nanbuwks/ESXAR/doc/ESXARPoster.jpg

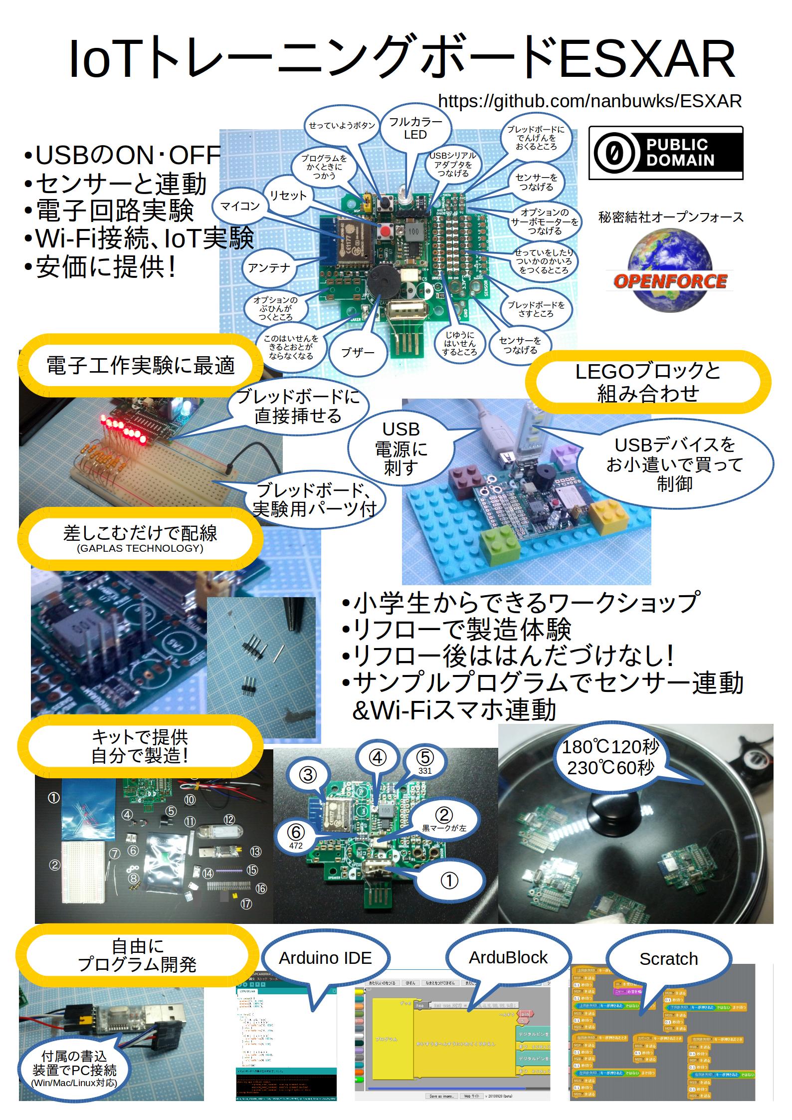
doc/ESXARPoster.jpg
