nanbuwks/ESXAR/doc/20160821IoTCost.pdf

Sheet1

ページ 1

金額は税込みです

調達価格 | | 部材価格（３倍） | ミニマムの場合
WROOM-02 | 450 | 1350
基板 | 100 | 300 | 300
FET | 100 | 300 | 30
ブレッドボード | 120 | 360 | 360
| 20 | 60 | 60
抵抗ｘ１０ | 10 | 30 | 30
温度センサ | 10 | 30 | 30
センサーねじ | 10 | 30 | 30
照度センサ | 10 | 30 | 30
スピーカ | 100 | 300 | 300
リードスイッチ | 25 | 75 | 75
| 100 | 300 | 0
集合抵抗 | 20 | 60 | 60
集合コンデンサ | 20 | 60 | 60
電源ユニット | 100 | 300 | 168
ピンヘッダ | 15 | 45 | 45
| 216 | 648
| 216 | 648
| 108 | 324
合計 | | 5250 | 1578

### 2016/8/21親子de電子工作キット部材コスト

LEDｘ４

USBメスコネクタ

USB電源
USB扇風機
USBライト
