nanbuwks/ESXAR/doc/光の流れ20160521wESP8266.pdf

## 日本アンドロイドの会秋葉原支部ロボット部

# 「ハードウェア」と「ソフトウェア」のワークショップ

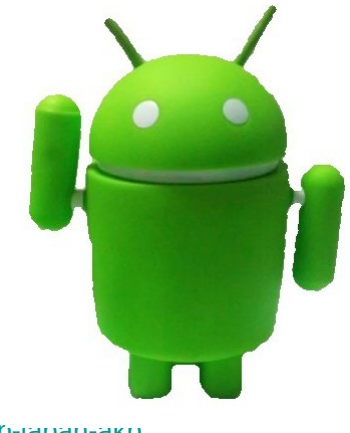
[picture p11: figure]

メーリングリスト：　　http://groups.google.com/group/robot-android-group-japan-akb Webサイト：　　　　　https://sites.google.com/site/akbrobot/

# 「光の流れ」 テキスト

### ESP8266のオリジナル電子基板を Arduino互換基板として使用して、 LEDを光るプログラムを作ります

# 「光の流れ」ワークショップ

### 目的： 「ハードウェア」と「ソフトウェア」に触れる

### 概要： 光の流れをつくる

### 対象： 小学生以上

### コース時間： 30分〜

### コース方式： 個別指導

### （１）コース説明 3分 （２）ハードウェア工作 １０分 （３）課題１（１つ点滅） ５分 （４）課題２（光の流れ） １０分 （５）まとめ、質問 3分 （６）追加の問題（流れを逆にするなど） １５分

概要

時間

# 全体のつながり

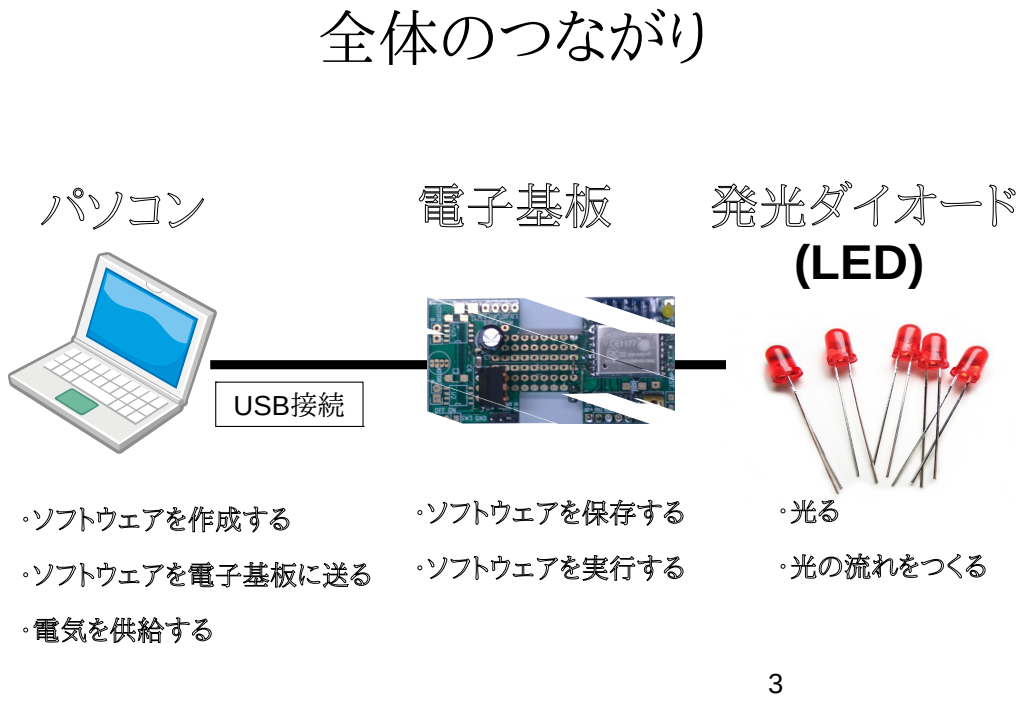
[picture p12: page 3]
・ソフトウェアを作成する; ・ソフトウェアを電子基板に送る; ・電気を供給する; ・ソフトウェアを保存する; ・ソフトウェアを実行する; ・光の流れをつくる; パソコン; 電子基板; 発光ダイオード; (LED); USB接続

# ハードウェア工作

### ①最初に先生が部品（抵抗、発光ダイオード、電線）を取り

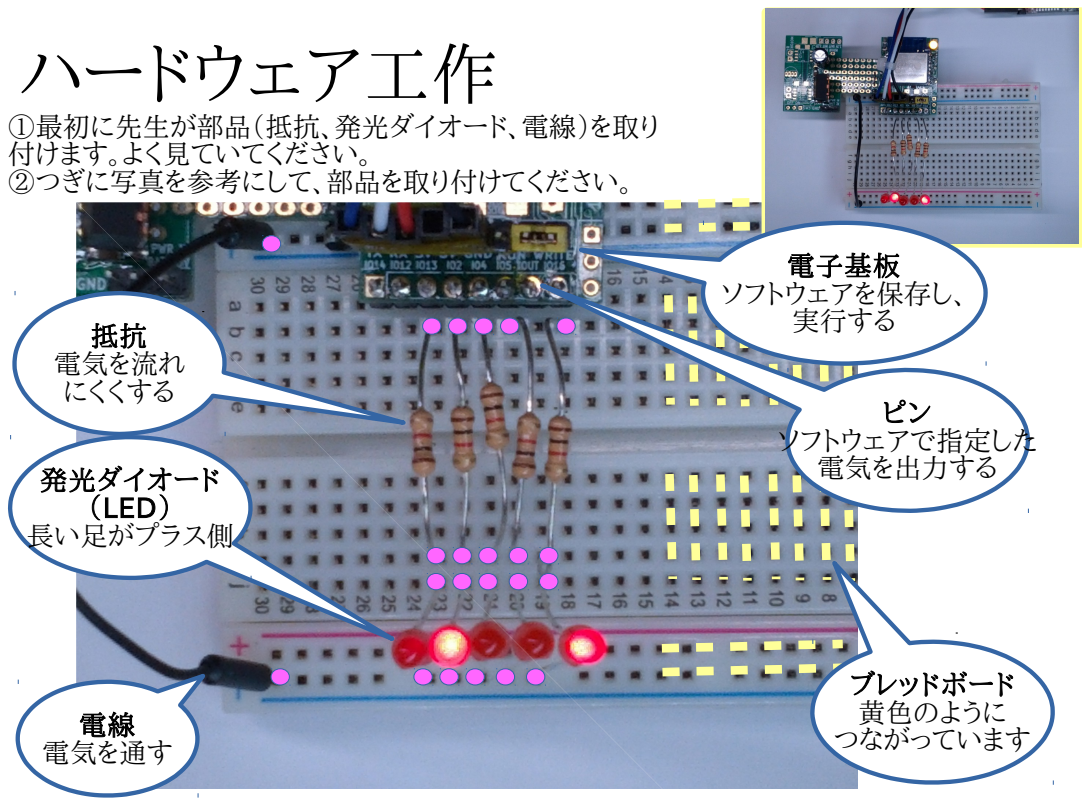
[picture p13: page 4]
付けます。よく見ていてください。 ②つぎに写真を参考にして、部品を取り付けてください。; 発光ダイオード （LED） 長い足がプラス側; 電線 電気を通す; 抵抗 電気を流れ にくくする; ブレッドボード 黄色のように つながっています; ピン ソフトウェアで指定した 電気を出力する; 電子基板 ソフトウェアを保存し、 実行する

# 「デモ１」 １つ点滅

### ソフトウェア１

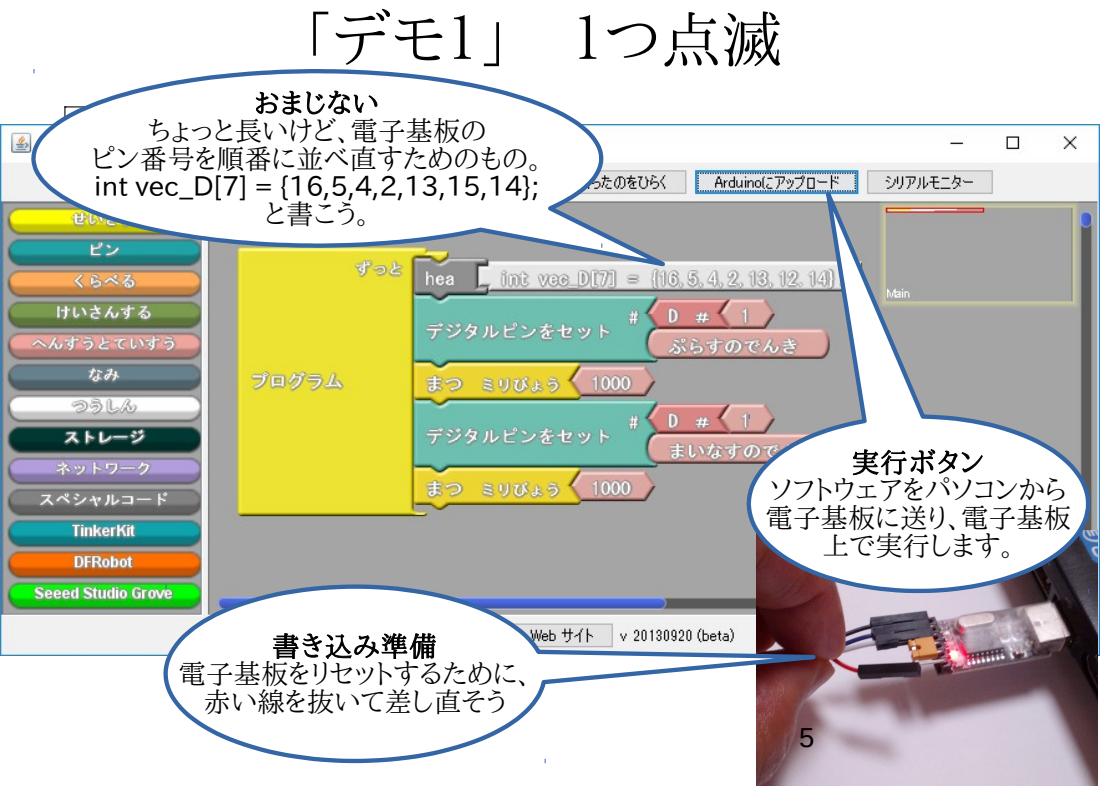
[picture p14: page 5]
実行ボタン ソフトウェアをパソコンから 電子基板に送り、電子基板 上で実行します。; おまじない ちょっと長いけど、電子基板の ピン番号を順番に並べ直すためのもの。 int vec_D[7] = {16,5,4,2,13,15,14}; と書こう。; 書き込み準備 電子基板をリセットするために、 赤い線を抜いて差し直そう

# 「デモ２」 光の流れ （発光ダイオード５本)

### ソフトウェア２

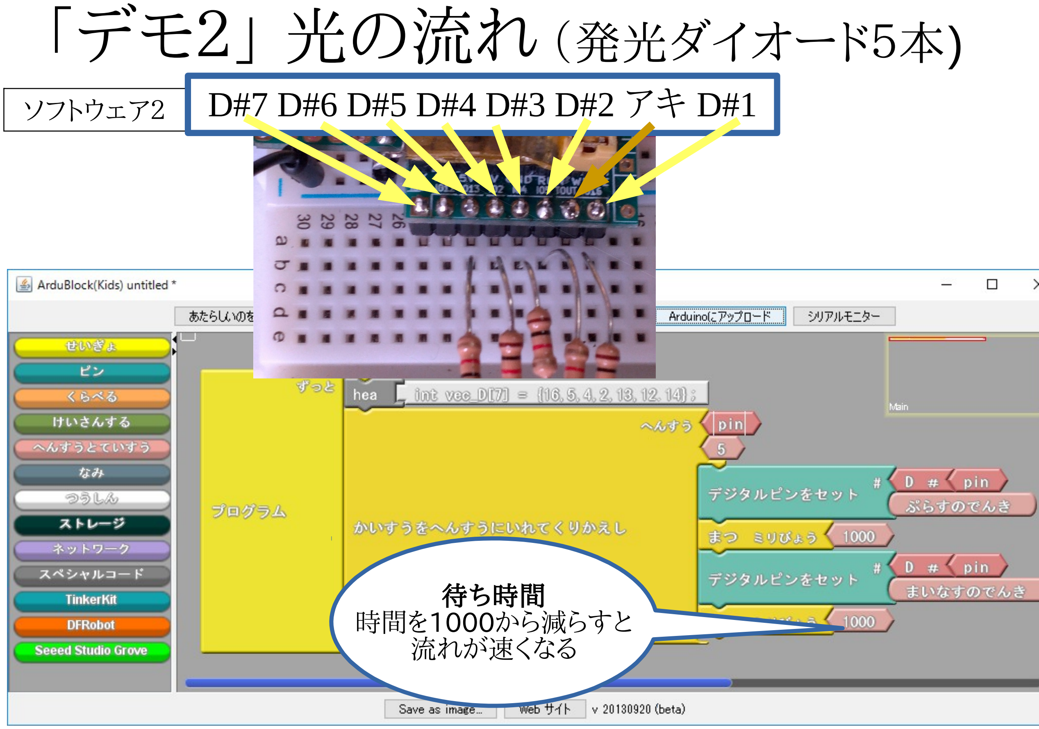
[picture p15: page 6]

### 待ち時間 時間を1000から減らすと 流れが速くなる

# D#7 D#6 D#5 D#4 D#3 D#2 アキ D#1

# 問題に挑戦しよう。

# （１）光の流れを逆方向にする （２）光の流れを折り返す （３）発光ダイオードを１つ増やす （４）その他

# 問題をとくアイデアは？

# もっと遊びたい

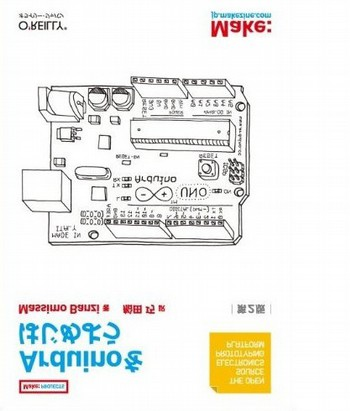
[picture p16: figure]

１．本

Arduino をはじめよう 第3版 (Make:PROJECTS) 　　￥ 2,160 入手先：アマゾン http://www.amazon.co.jp/ など

２．ハードウェア （つぎのいづれか）

（１）本テキストで使用した電子基板、部品　　「AKBONE」　価格は問い合わせください 入手先：ロボット部　http://groups.google.com/group/robot-android-group-japan-akb

（２）「Arduinoで利口なガジェット」用実験キット ￥1500
入手先：アマゾン、秋葉原　若松通商など

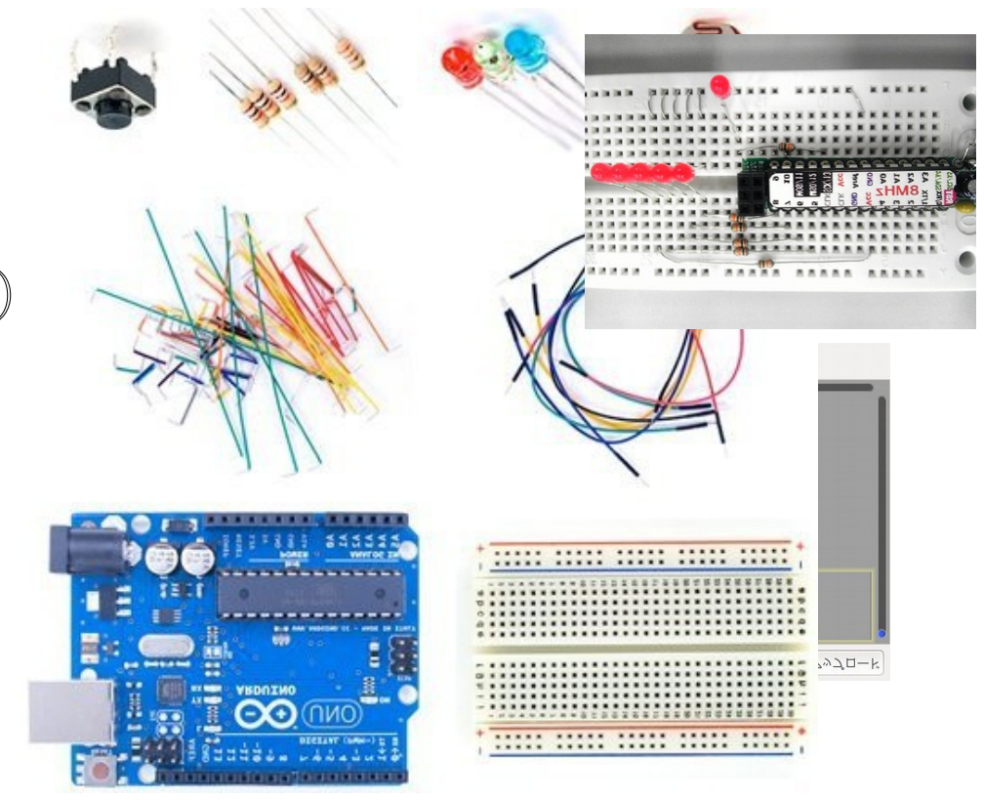
[picture p17: figure]

３．ソフトウェア開発ソフト　 （本テキストで使用したソフト）

Arduino IDE　無料　　開発環境
ArduBlock 　無料　　ビジュアルプログラミング環境

ダウンロードやインストール方法は、ロボット部の
「プロジェクトAKBONE」　などを参考にしてください。 <http://sourceforge.jp/projects/akbone>

# 参加ありがとう！
