nanbuwks/ESXAR/(threads)

Thread 3 (2016-07-29):

Bug on 4.7kOhm registor array pin assign

nanbuwks, 2016-07-29:

nanbuwks, 2016-08-02:
Done

Closed 2016-08-02.
