nanbuwks/ESXAR/doc/ESXARPoster.pdf

## リセット

## アンテナ

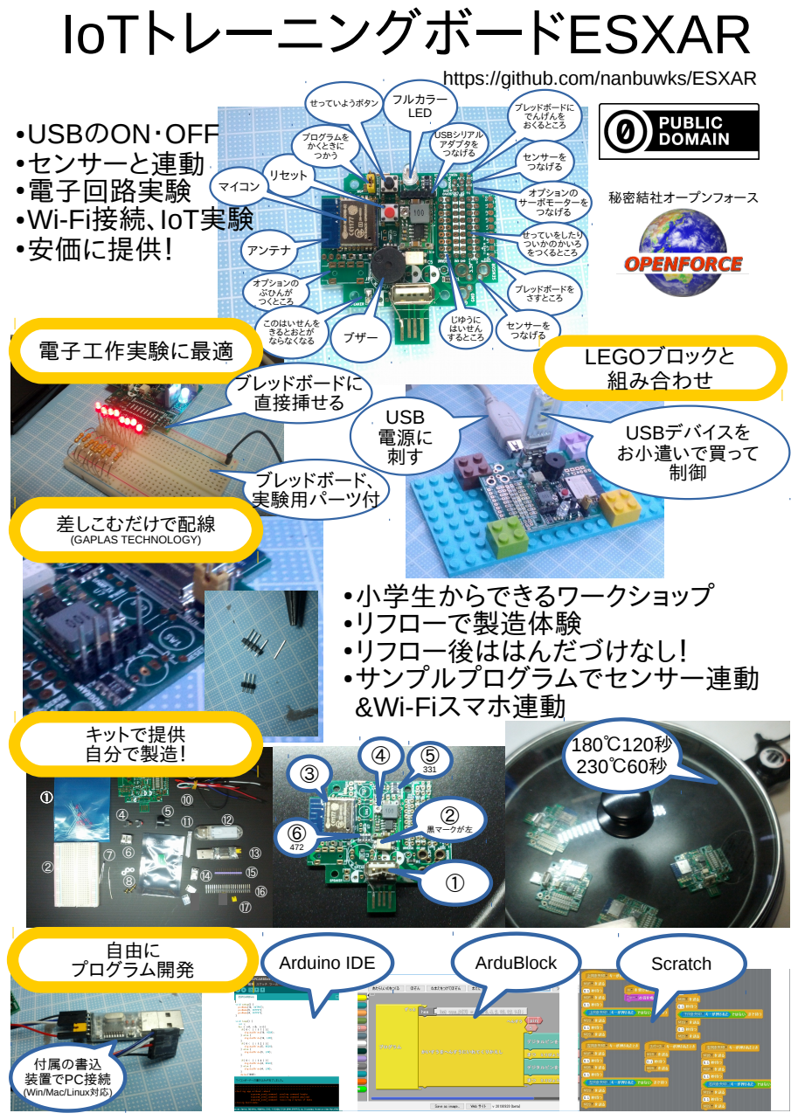
[picture p18: page 1]
黒マークが左; USB 電源に 刺す; ブザー; オプションの ぶひんが つくところ; プログラムを かくときに つかう; ブレッドボードに でんげんを おくるところ; センサーを つなげる; オプションの サーボモーターを つなげる; ブレッドボードを さすところ; このはいせんを きるとおとが ならなくなる; フルカラー LED; じゆうに はいせん するところ; USBデバイスを お小遣いで買って 制御; マイコン; USBシリアル アダプタを つなげる; せっていようボタン; せっていをしたり ついかのかいろ をつくるところ; ●小学生からできるワークショップ ●リフローで製造体験 ●リフロー後ははんだづけなし！ ●サンプルプログラムでセンサー連動 &Wi-Fiスマホ連動; IoTトレーニングボードESXAR; 秘密結社オープンフォース; Arduino IDE; ArduBlock; Scratch; 自由に プログラム開発; キットで提供 自分で製造！; 差しこむだけで配線; (GAPLAS TECHNOLOGY); 電子工作実験に最適; LEGOブロックと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

https://github.com/nanbuwks/ESXAR

●USBのON・OFF
●センサーと連動
●電子回路実験
●Wi-Fi接続、IoT実験
●安価に提供！

付属の書込
装置でPC接続
(Win/Mac/Linux対応)
