nanbuwks/ESXAR/doc/ESXARVer20160715HOWTOUSE.pdf

# ESXAR 詳しい資料

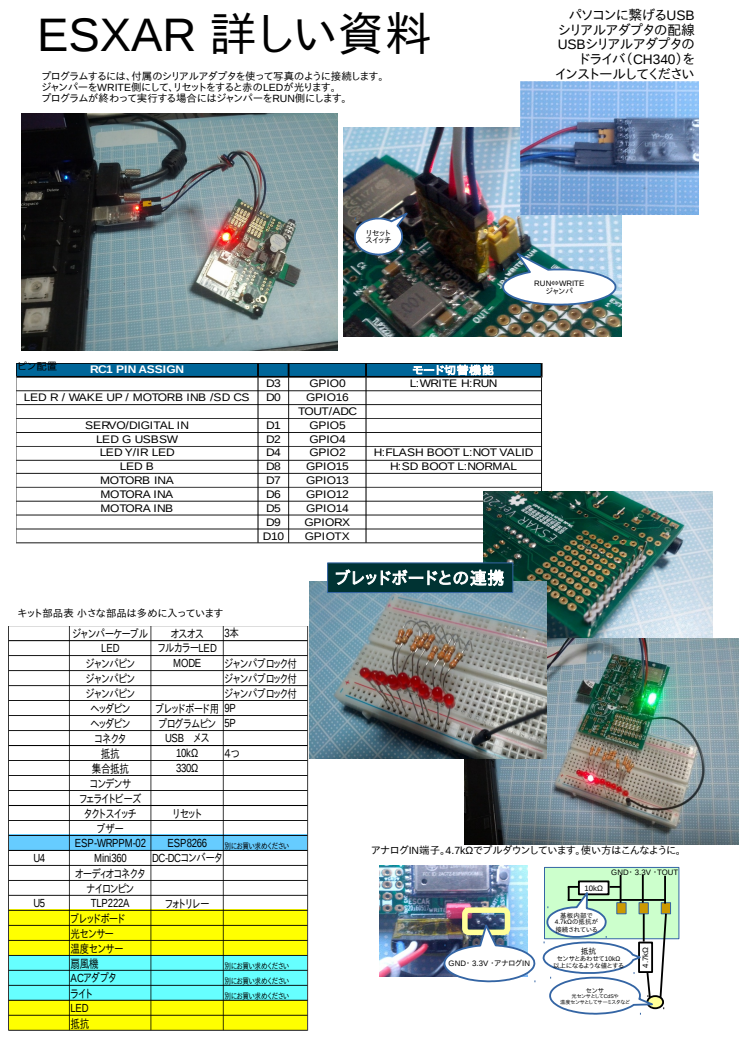
[picture p19: page 1]
