nanbuwks/ESXAR/ESXAR.kicad_pcb

## KiCad design ESXAR.kicad_pcb (2016-10-04)

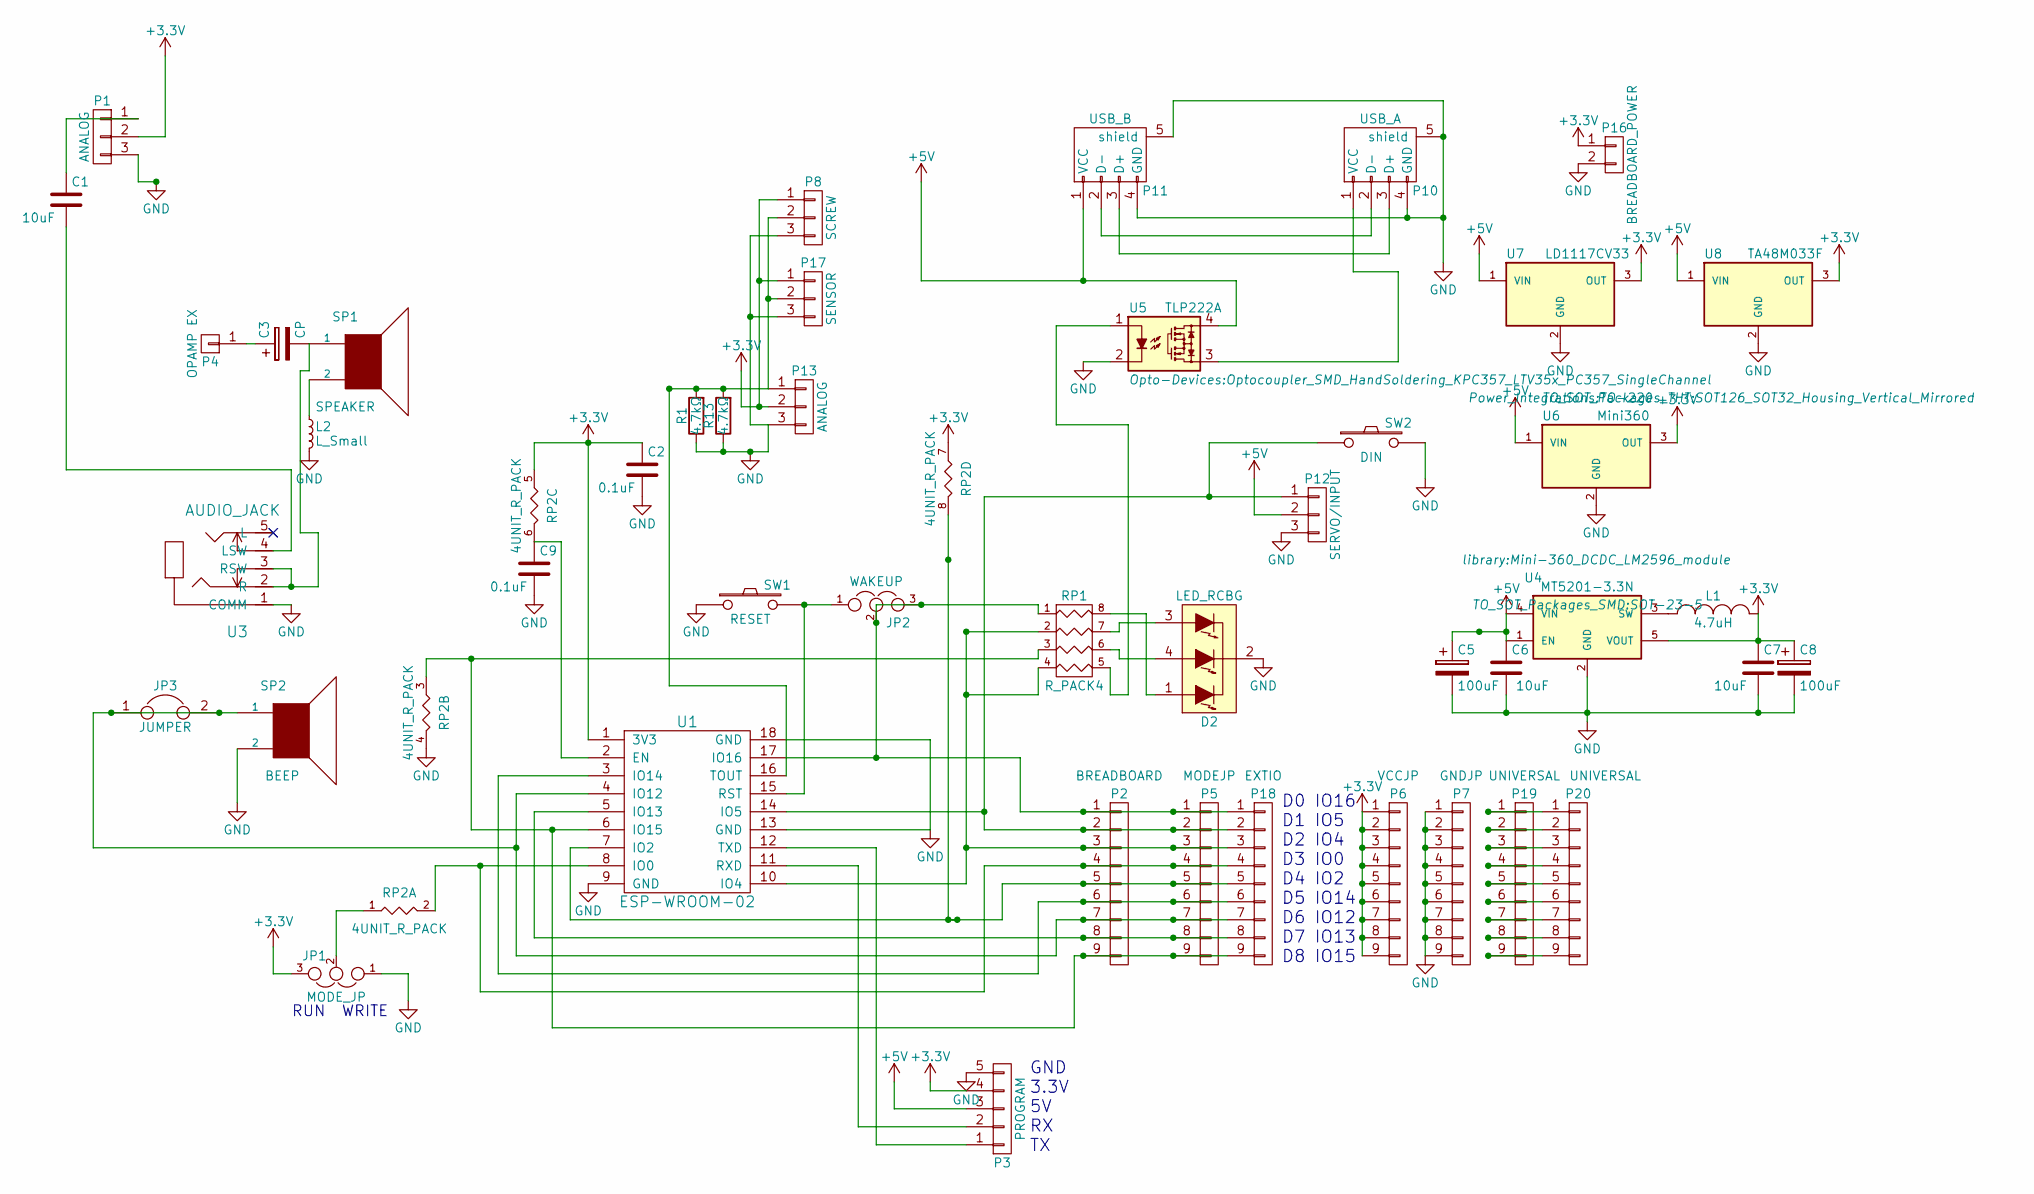
[picture p22: schematic ESXAR.sch]

Parts:
C1: 10uF; C_Disc_D3_P2.5
C2, C9: 0.1uF; C_1206_HandSoldering_Small
C3: CP; C_Radial_D6.3_L11.2_P2.5
C5, C8: 100uF; C_Radial_D6.3_L11.2_P2.5
C6, C7: 10uF; C_1206_HandSoldering_Small
D2: LED_RCBG; LED-RGB-5MM_Common_Cathode
JP1: MODE_JP; SolderWirePad_Oval_3xInline_0-65mmDrill
JP2: WAKEUP; Solder_Jumper_3
JP3: JUMPER; Pin_Header_Straight_1x02
L1: 4.7uH; C_1206_HandSoldering_Small
L2: L_Small; C_1206_HandSoldering_Small
P1, P13: ANALOG; SolderWirePad_Oval_3xInline_0-65mmDrill
P2: BREADBOARD; SolderWirePad_Oval_9xInline_0-6mmDrill
P3: PROGRAM; SolderWirePad_Oval_5xInline_0-65mmDrill
P4: OPAMP EX; SolderWirePad_single_0-8mmDrill
P5: MODEJP; SolderWirePad_Oval_9xInline_0-6mmDrill
P6: VCCJP; SolderWirePad_Oval_9xInline_0-6mmDrill
P7: GNDJP; SolderWirePad_Oval_9xInline_0-6mmDrill
P8: SCREW; bornier3
P10: USB_A; USB_A_Vertical_Short
P11: USB_B; USB_A_Male_Board
P12: SERVO/INPUT; SolderWirePad_Oval_3xInline_0-65mmDrill
P16: BREADBOARD_POWER; Padmatrix-wide-02x01
P17: SENSOR; bornier3
P18: EXTIO; SolderWirePad_Oval_9xInline_0-7mmDrill
P19, P20: UNIVERSAL; SolderWirePad_Oval_9xInline_0-7mmDrill
R1: 4.7kΩ; R_1206
R13: 4.7kΩ; R1
RP1: R_PACK4; R_Array_Convex_4x1206
RP2: 4UNIT_R_PACK; R_Array_For_R_Multi_library_4x1206
SP1: SPEAKER; Buzzer_12x9.5RM7.6
SP2: BEEP; Buzzer_12x9.5RM7.6
SW1: RESET; SW_PUSH_SMALL
SW2: DIN; SW_PUSH_SMALL
U1: ESP-WROOM-02; ESP_WROOM_02
U3: AUDIO_JACK; 3_5mm_4P_phonejack_yizhijia_PJ313
U4: MT5201-3.3N; SOT-23-5
U5: TLP222A; Optocoupler_SMD_HandSoldering_KPC357_LTV35x_PC357_SingleCha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
U6: Mini360; Mini-360_DCDC_LM2596_module
U7: LD1117CV33; TO-220
U8: TA48M033F; SOT126_SOT32_Housing_Vertical_Mirrored

Connections:
+3V3: C2.1, C7.1, C8.1, JP1.3, L1.2, P1.2, P3.4, P6.1, P6.2, P6.3, P6.4, P6.5, P6.6, P6.7, P6.8, P6.9, P8.1, P13.2, P16.1, P17.1, RP2.5 (P1), RP2.7 (P1), U1.1 (3V3), U4.5 (VOUT), U6.3 (OUT), U7.3 (OUT), U8.3 (OUT)
+5V: C5.1, C6.1, P3.3, P11.1 (VCC), P12.2, U4.1 (EN), U4.4 (VIN), U5.4, U6.1 (VIN), U7.1 (VIN), U8.1 (VIN)
GND: C2.2, C5.2, C6.2, C7.2, C8.2, C9.2, D2.2 (COMMON_CATHODE), JP1.1, L2.2, P1.3, P3.5, P7.1, P7.2, P7.3, P7.4, P7.5, P7.6, P7.7, P7.8, P7.9, P8.3, P10.4 (GND), P10.5 (shield), P11.4 (GND), P11.5 (shield), P12.3, P13.3, P16.2, P17.3, R1.1, R13.1, RP2.4 (R1), SP2.2, SW1.1, SW2.2, U1.9 (GND), U1.13 (GND), U1.18 (GND), U3.1 (COMM), U4.2 (GND), U5.2, U6.2 (GND), U7.2 (GND), U8.2 (GND)
unnamed: C1.1, P1.1
unnamed: C1.2, U3.4 (LSW)
unnamed: C3.1, P4.1
unnamed: C3.2, SP1.1, U3.2 (R), U3.3 (RSW)
unnamed: C9.1, RP2.6 (R1), U1.2 (EN)
unnamed: D2.1 (RED_ANODE), RP1.8 (R1)
unnamed: D2.3 (BLUE_ANODE), RP1.7 (R2)
unnamed: D2.4 (GREEN_ANODE), RP1.6 (R3)
unnamed: JP1.2, RP2.1
unnamed: JP2.1, SW1.2, U1.15 (RST)
unnamed: JP2.2, JP2.3, P2.1, P5.1, P18.1, RP1.1, U1.17 (IO16)
unnamed: JP3.1, JP3.2, P2.7, P5.7, P18.7, SP2.1, U1.4 (IO12)
unnamed: L1.1, U4.3 (SW)
unnamed: L2.1, SP1.2
unnamed: P3.1, U1.12 (TXD)
unnamed: P3.2, U1.11 (RXD)
unnamed: P10.1 (VCC), U5.3
unnamed: P10.2 (D-), P11.2 (D-)
unnamed: P10.3 (D+), P11.3 (D+)
unnamed: P2.2, P5.2, P12.1, P18.2, SW2.1, U1.14 (IO5)
unnamed: P8.2, P13.1, P17.2, R1.2, R13.2, U1.16 (TOUT)
unnamed: P2.3, P5.3, P18.3, RP1.2, RP1.4, U1.10 (IO4)
unnamed: P2.4, P5.4, P18.4, RP2.2 (R1), U1.8 (IO0)
unnamed: P2.5, P5.5, P18.5, RP2.8 (R1), U1.7 (IO2)
unnamed: P2.6, P5.6, P18.6, U1.3 (IO14)
unnamed: P2.8, P5.8, P18.8, U1.5 (IO13)
unnamed: P2.9, P5.9, P18.9, RP1.3, RP2.3 (P1), U1.6 (IO15)
unnamed: P19.1, P20.1
unnamed: P19.2, P20.2
unnamed: P19.3, P20.3
unnamed: P19.4, P20.4
unnamed: P19.5, P20.5
unnamed: P19.6, P20.6
unnamed: P19.7, P20.7
unnamed: P19.8, P20.8
unnamed: P19.9, P20.9
unnamed: RP1.5 (R4), U5.1

Notes on the sheet:
RUN WRITE
GND 3.3V 5V RX TX
D0 IO16 D1 IO5 D2 IO4 D3 IO0 D4 IO2 D5 IO14 D6 IO12 D7 IO13 D8 IO15

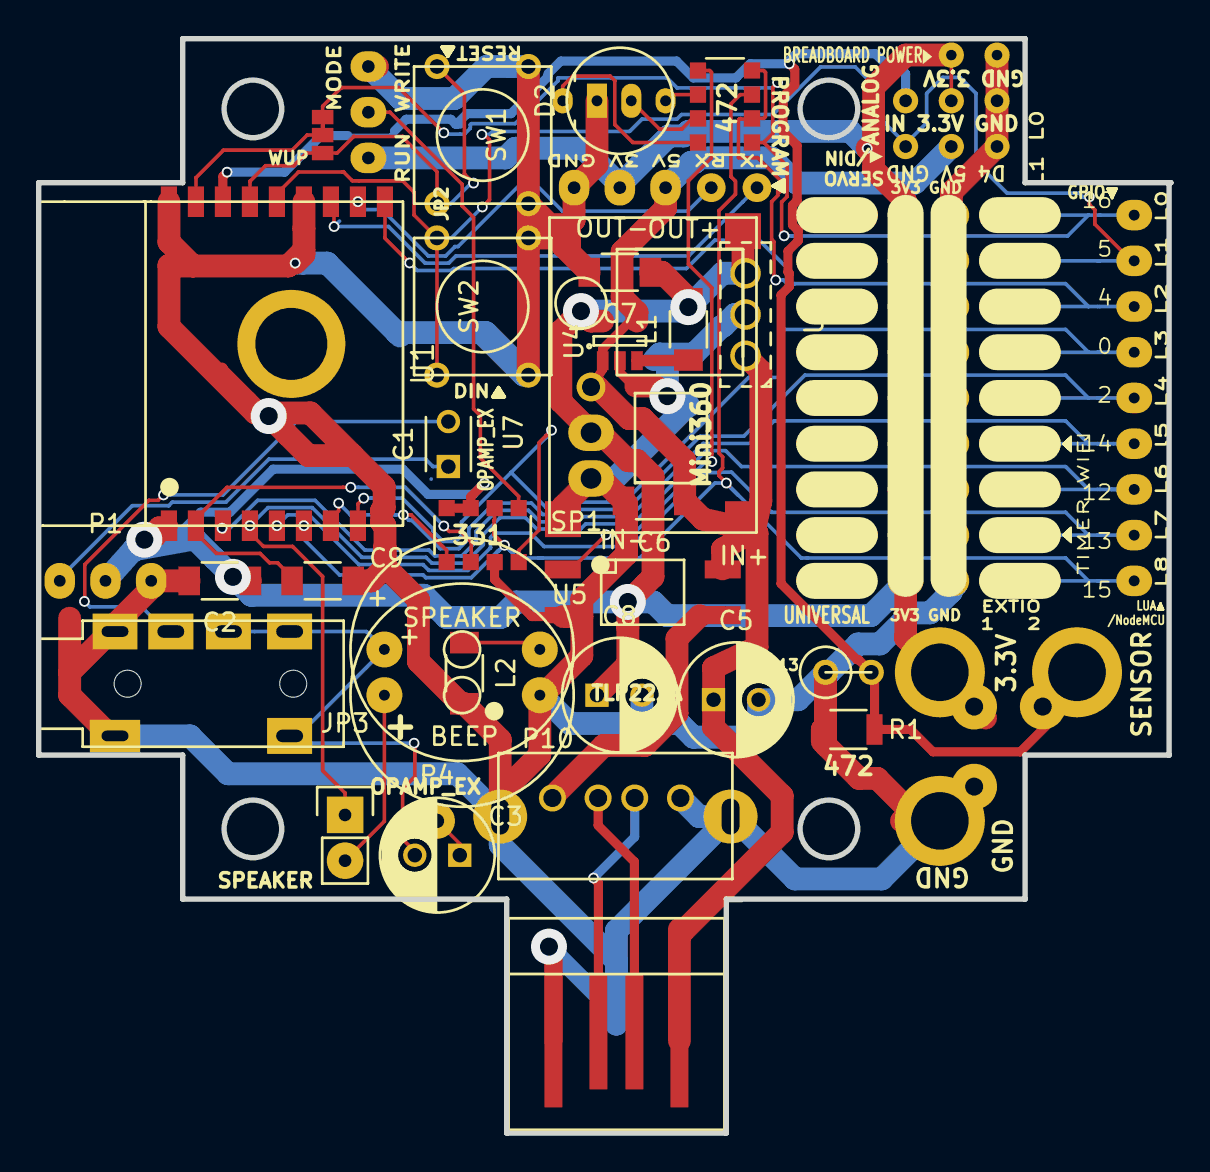
[picture p23: board ESXAR.kicad_pcb from above]

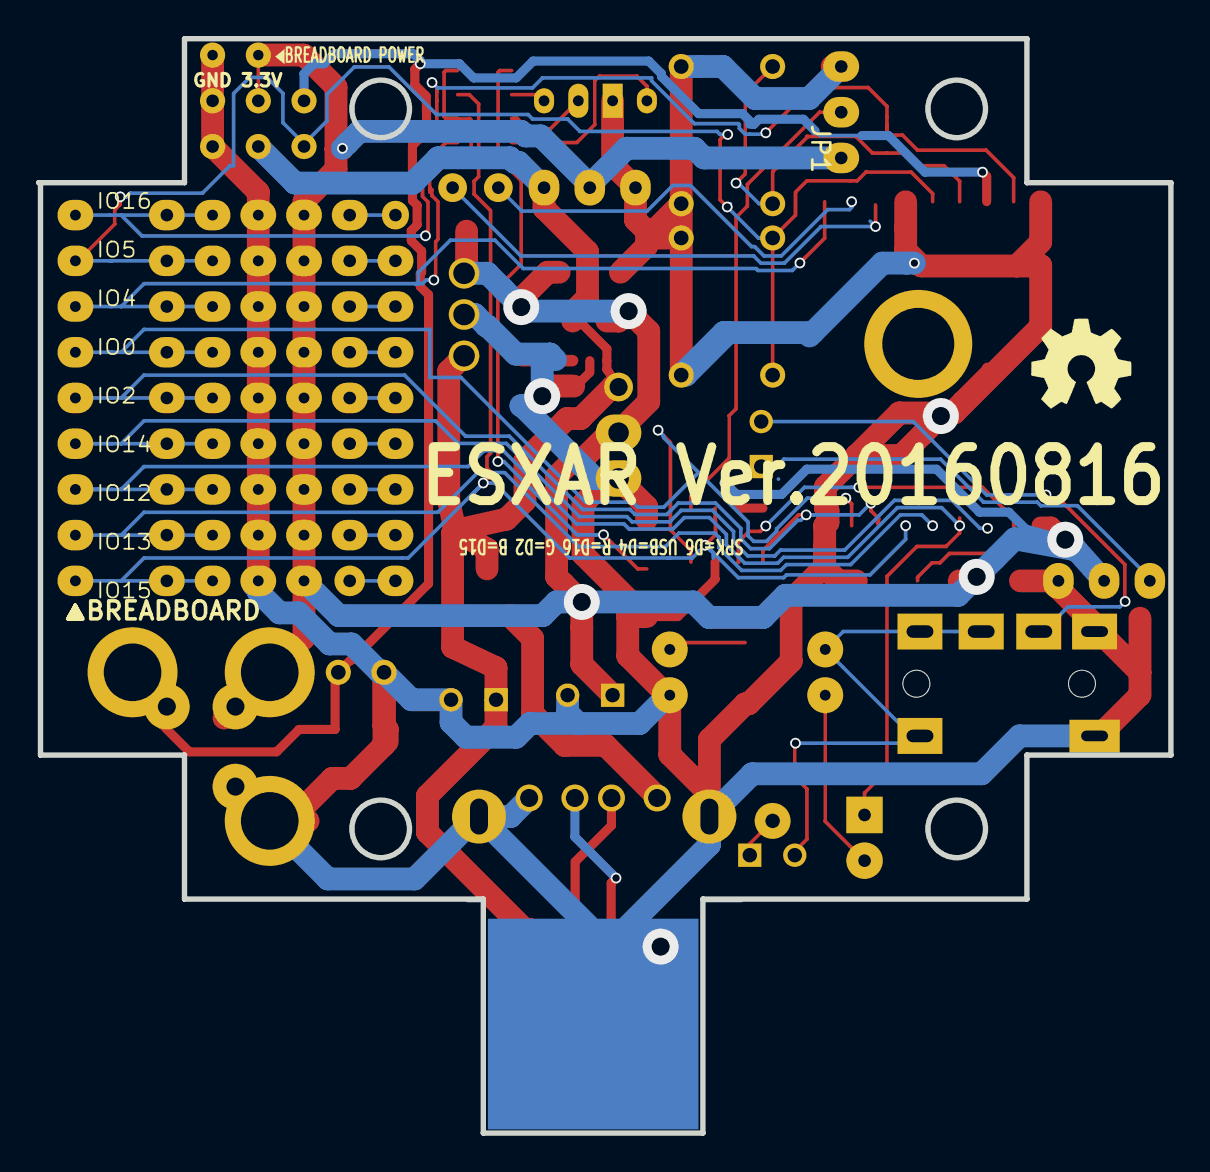
[picture p24: board ESXAR.kicad_pcb from below]

Board: 2 copper layers, 62.8 x 60.8 mm, 47 parts (4 on the bottom side), 40 nets.

Other parts of the board:
OSHW: 1.1; OSHW_LOGL_SYLK_5mm
