nanbuwks/ESXAR/(commit log)

2016-07-29 first commit Ver20160715
    [ESXAR-B.Cu.gbr, ESXAR-B.Mask.gbr, ESXAR-B.SilkS.gbr, ESXAR-Edge.Cuts.gbr, ESXAR-F.Cu.gbr, ESXAR-F.Mask.gbr, ESXAR-F.SilkS.gbr, ESXAR-NPTH.drl]
2016-07-29 add some documents
    [20160821IoTCost.ods]
2016-08-02 Change IO Ext pin direction, and througehwole size.
    [ESXAR.kicad_pcb, ESXAR.sch]
2016-08-02 fix registor array bug
    [ESXAR.kicad_pcb, ESXAR.sch]
2016-08-03 Ver 20160802. add speaker jumper,change analog port layout, etc.
    [ESXAR-B.Cu.gbr, ESXAR-B.Mask.gbr, ESXAR-B.SilkS.gbr, ESXAR-Edge.Cuts.gbr, ESXAR-F.Cu.gbr, ESXAR-F.Mask.gbr, ESXAR-F.SilkS.gbr, ESXAR-NPTH.drl]
2016-08-05 Ver 20160804 Layout Change.
    [ESXAR-B.Cu.gbr, ESXAR-B.Mask.gbr, ESXAR-B.SilkS.gbr, ESXAR-Edge.gko, ESXAR-F.Cu.gbr, ESXAR-F.Mask.gbr, ESXAR-F.SilkS.gbr, ESXAR-NPTH.drl]
2016-08-16 Ver.20160805 change outline, rayout, delete opamp, etc...
    [ESXAR.kicad_pcb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]
2016-08-28 Ver.20170816 and documents
    [20160821IoTCost.ods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]
2016-10-04 Document update
    [ESXAR.kicad_pcb]
